Serein-28y/STM32_Smart_Car/文本记录/README.md

本项目的完整说明文档已经移动到仓库根目录，请查看：

[STM32 智能小车 README](../README.md)
