Serein-28y/STM32_Smart_Car/相关代码及PCB设计/V2.0.1/(UP主陈加油)STM32F1智能小车扩展板原理图.png

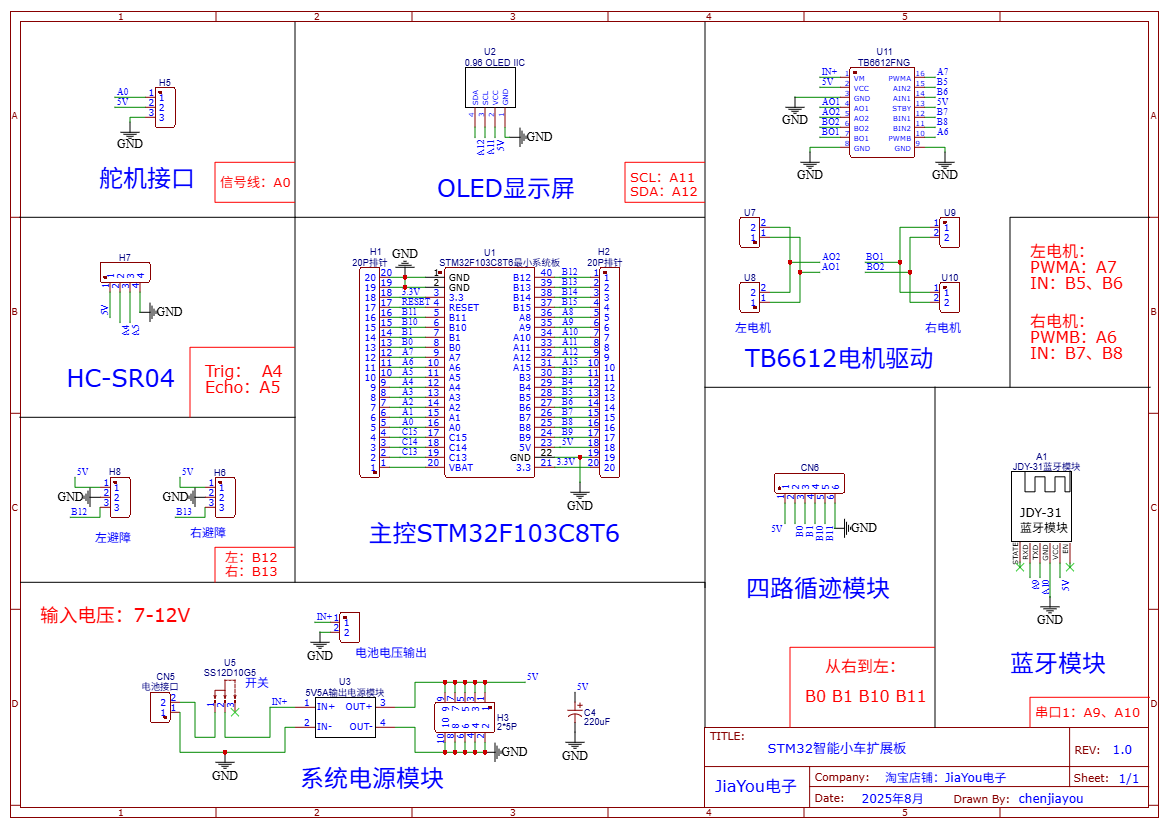
相关代码及PCB设计/V2.0.1/(UP主陈加油)STM32F1智能小车扩展板原理图.png
