Serein-28y/STM32_Smart_Car/相关代码及PCB设计/V2.0.1/SCH_STM32智能小车扩展板原理图_1-P1_2026-08-20.png

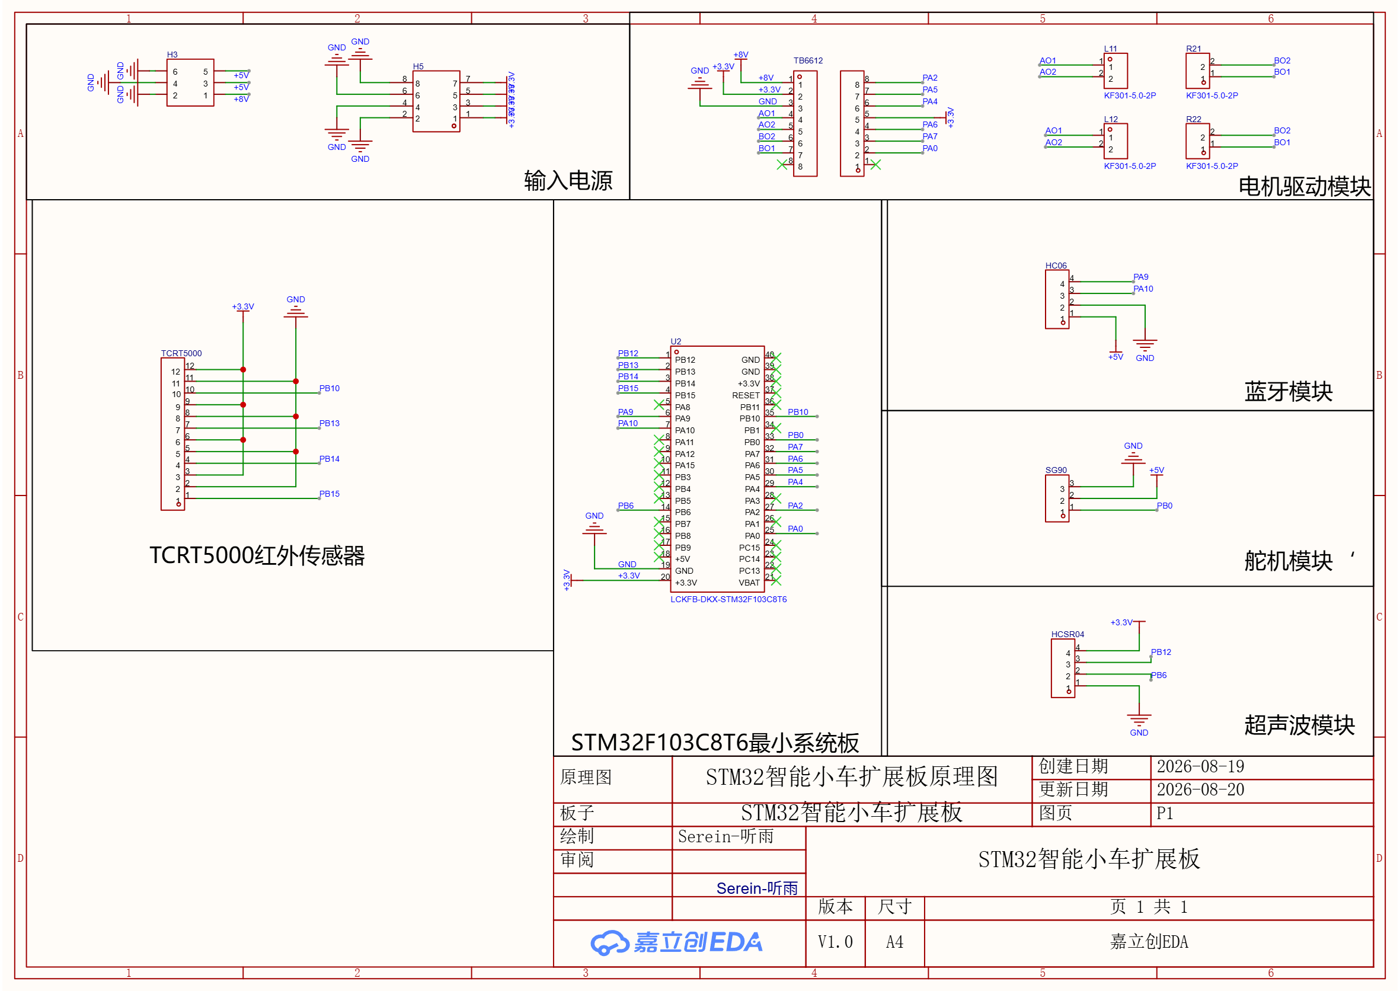
相关代码及PCB设计/V2.0.1/SCH_STM32智能小车扩展板原理图_1-P1_2026-08-20.png
