Serein-28y/STM32_Smart_Car/相关知识/GPIO输入输出模式.png

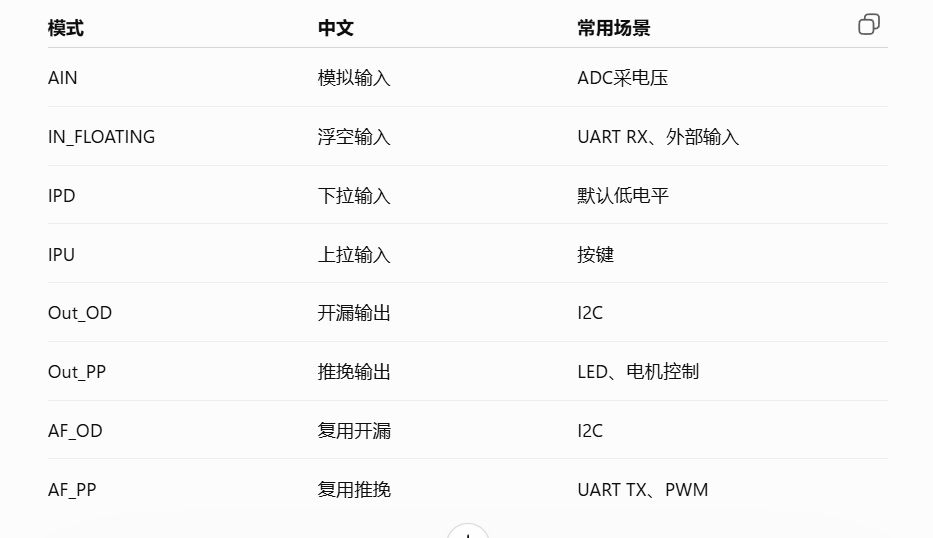
相关知识/GPIO输入输出模式.png
