Serein-28y/STM32_Smart_Car/相关知识/PWM参数计算.jpg

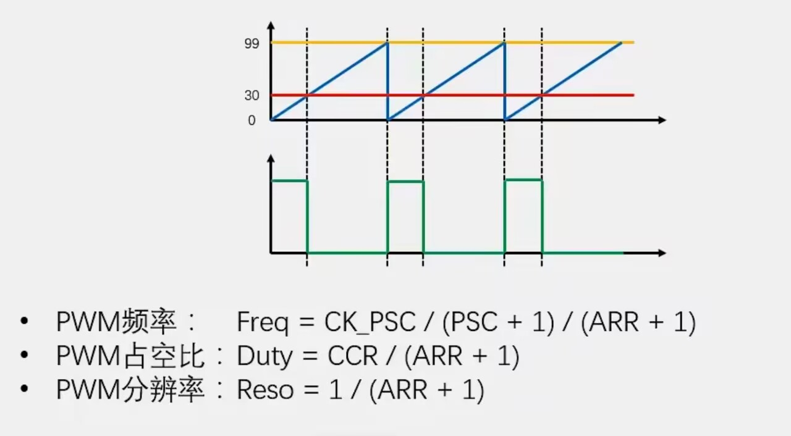
相关知识/PWM参数计算.jpg
