Serein-28y/STM32_Smart_Car/相关知识/系统架构.png

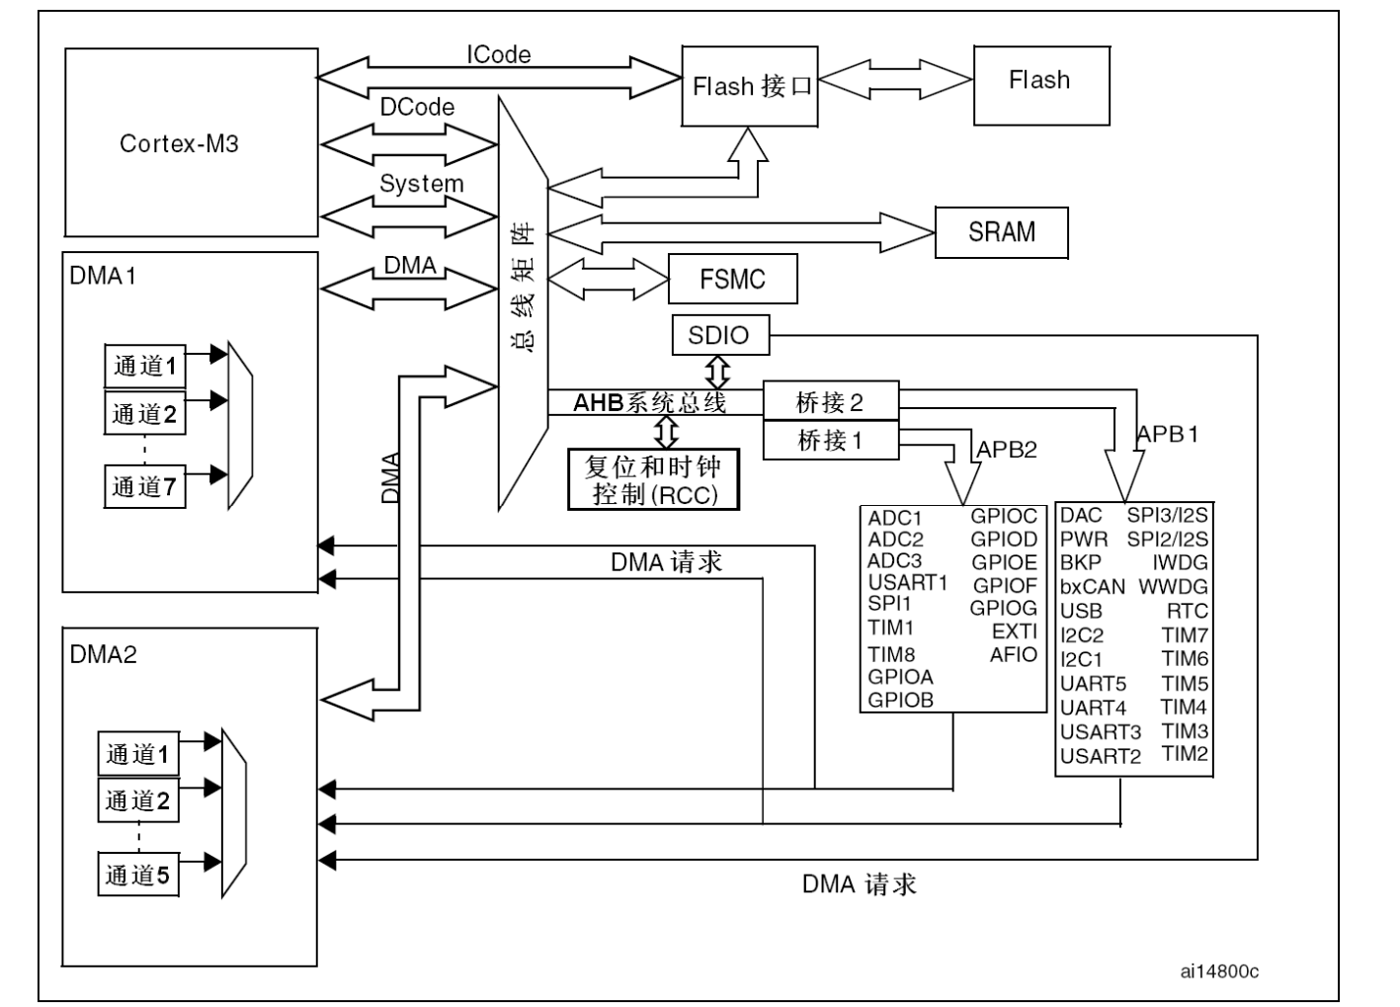
相关知识/系统架构.png
