Serein-28y/STM32_Smart_Car/相关代码及PCB设计/V2.0.1/BOM_STM32智能小车扩展板_STM32智能小车扩展板原理图_2026-08-20.xlsx

No. | Quantity | Comment | Designator | Footprint | Value | Manufacturer Part | Manufacturer | Supplier Part | Supplier
1 | 1 | HDR-M_2.54_2x3 | H3 | HDR-TH_6P-P2.54-V-R2-C3-S2.54_A2541WV-2X3P |  |  |  | C402781
2 | 2 | HDR-F_2.54_1x8P | H4,TB6612 | HDR-TH_8P-P2.54-V-F-1 |  |  |  | C27438
3 | 1 | HDR-M_2.54_2x4 | H5 | HDR-TH_8P-P2.54-V-M-R2-C4-S2.54 |  |  |  | C124386
4 | 1 | HDR-F_2.54_1x4P | HC06 | HDR-TH_4P-P2.54-V-F |  |  |  | C2718488
5 | 1 | HDR-M_2.54_1x4P | HCSR04 | HDR-TH_4P-P2.54-V-M |  |  |  | C492403
6 | 4 | KF301-5.0-2P | L11,L12,R21,R22 | CONN-TH_P5.00_KF301-5.0-2P |  | KF301-5.0-2P | KEFA(科发) | C474881 | LCSC
7 | 1 | HDR-M_2.54_1x3P | SG90 | HDR-TH_3P-P2.54-V-M |  |  |  | C2937625
8 | 1 | HDR-M_2.54_1x12P | TCRT5000 | HDR-TH_12P-P2.54-V-M |  |  |  | C2840012
9 | 1 | LCKFB-DKX-STM32F103C8T6 | U2 | CONN-TH_L53.3-W22.9_STM32F103C8T6-CARD |  | LCKFB-DKX-STM32F103C8T6 | 立创开发板 | C22396880 | LCSC
