Serein-28y/STM32_Smart_Car/(list of files, cad)

Other CAD files:
相关模块资料/模块资料/TCRT5000循迹模块/传感器51测试程序/STARTUP.OBJ
相关模块资料/模块资料/TCRT5000循迹模块/传感器51测试程序/1.OBJ
