Serein-28y/STM32_Smart_Car/文本记录/Problem.txt

1.焊接电机时没有考虑后面接线，线太细导致接线不稳
2.7_16解决PWM驱动四个TT电机，采用一个PWM1来输出波形，用通道1和通道3控制左右轮转速
3.7_17解决了供电问题，第一次测试用的四节南孚电池6V(测试电压为6.5V左右)，分两路，一路接TB6612的VM和GND端，一路通过AMS1117稳压3.3V接到STM32的3.3V和GND端
后续将采用锂电池18650供电7.4V（测试电压8.V左右）
4.

5.

6.7.30版的自动避障代码，
预测应为直行时检测到障碍物停车，然后后退，再左转一些距离然后停车
实际:检测到障碍物停车，然后一直在后退左转循环，检测出右边两个电机不转
8.6 将四节南孚电池换成12V18650，然后通过DC端口接四路电源模块，分别到3.3V提供STM32 TB6612逻辑电源，5V提供蓝牙和舵机模块
8V提供TB6612的VM
最后右侧电机还是不转，用万用表检测TB6612除了BO1和BO2两侧无电压，其他一切正常
将TB6612从面包板拆下来直接用杜邦线接各个IO口恢复基本正常，有时候需要调整接线
初步判断是面包板和TB6612 接触不良导致

8.6
开始自动避障进阶（加入舵机扫描）
8.7测试误差 速度50时，刹车有11cm的误差
舵机方向反了，避障的方向就会反！

后续硬件设计注意事项：
1. 目前电机连接线过细，连接不够牢固；后续更换质量更好、线径更合适且接口更可靠的连接线。
2. 面包板使用时间越长，越容易出现松动或接触不良，从而增加偶发故障。后续设计PCB控制板，减少面包板和临时接线的使用，提高整车连接的稳定性和可靠性。

后续 PCB 改进（V2.0.2）
1. 板子未加电源检测 LED，无法直观判断是否上电；需在电源轨与 GND 之间增加带限流电阻的电源指示 LED。
2. HC-06 蓝牙模块与 STM32 最小系统板距离过近，布局拥挤且可能相互干扰；需调整蓝牙接口位置，保持安全间距。
3. 板子上有两个电机接口的引脚序/极性接反，导致对应电机反转；需交换引脚序或修正丝印极性。
4. 电机线等走线在结构上可能需要绕线，存在交叉与遮挡；需优化接口位置、走线走向、接口防松与安装孔布局。
