Serein-28y/STM32_Smart_Car/相关代码及PCB设计/V2.0.1/SCH_STM32智能小车扩展板原理图_2026-08-20.pdf

输入电源 | 电机驱动模块

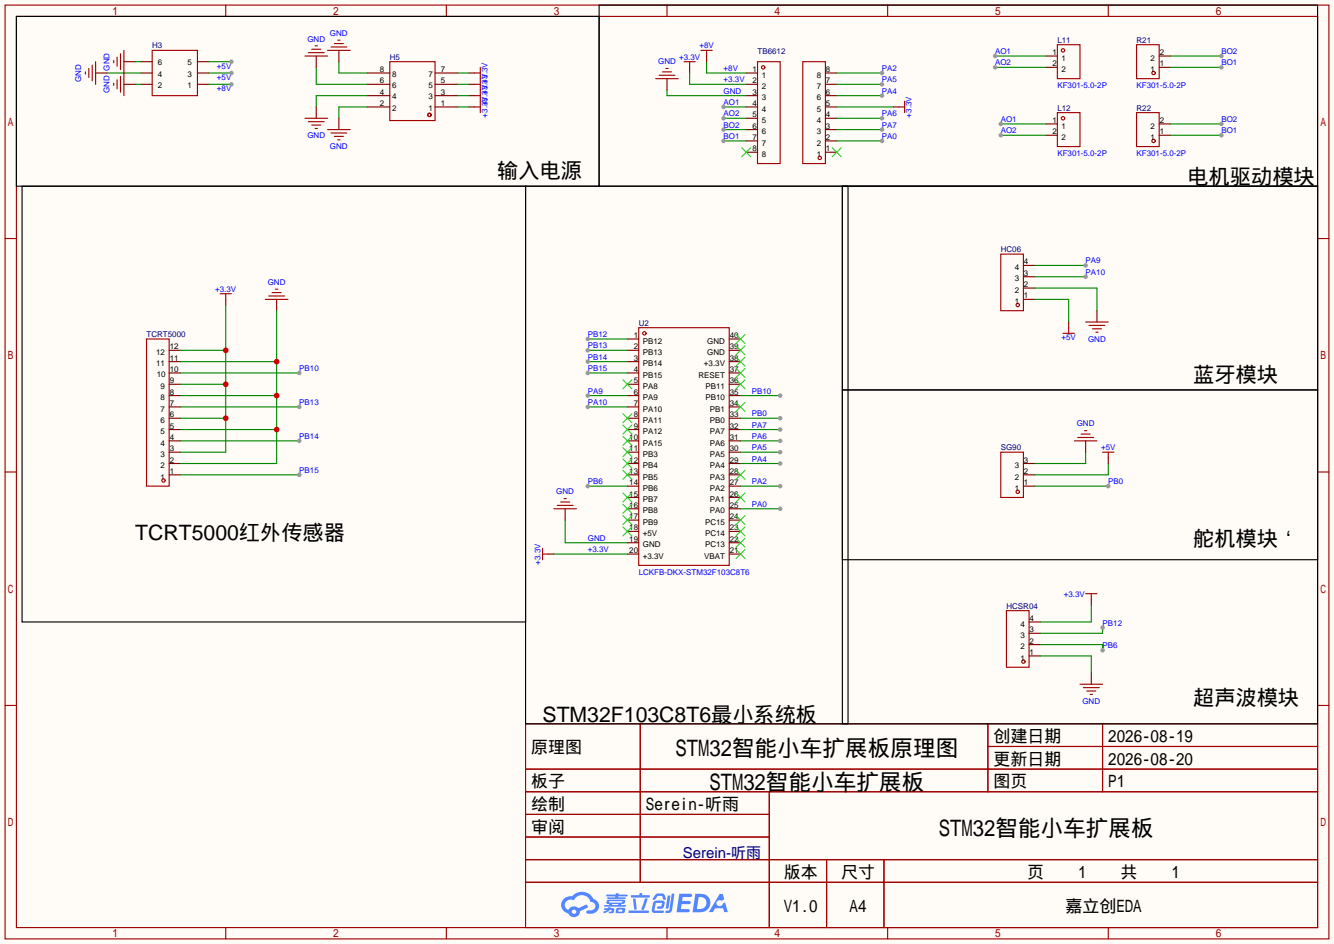
[picture p19: page 1]

原理图 | STM32智能小车扩展板原理图 | 创建日期 | 2026-08-19
板子 | STM32智能小车扩展板 | 图页 | P1
绘制 | Serein-听雨 | STM32智能小车扩展板
审阅

更新日期 | 2026-08-20

Serein-听雨

V1.0 | A4 | 嘉立创EDA
