Serein-28y/STM32_Smart_Car/相关模块资料/模块资料/TB6612FNG/TB6612电机驱动模块 (1).pdf

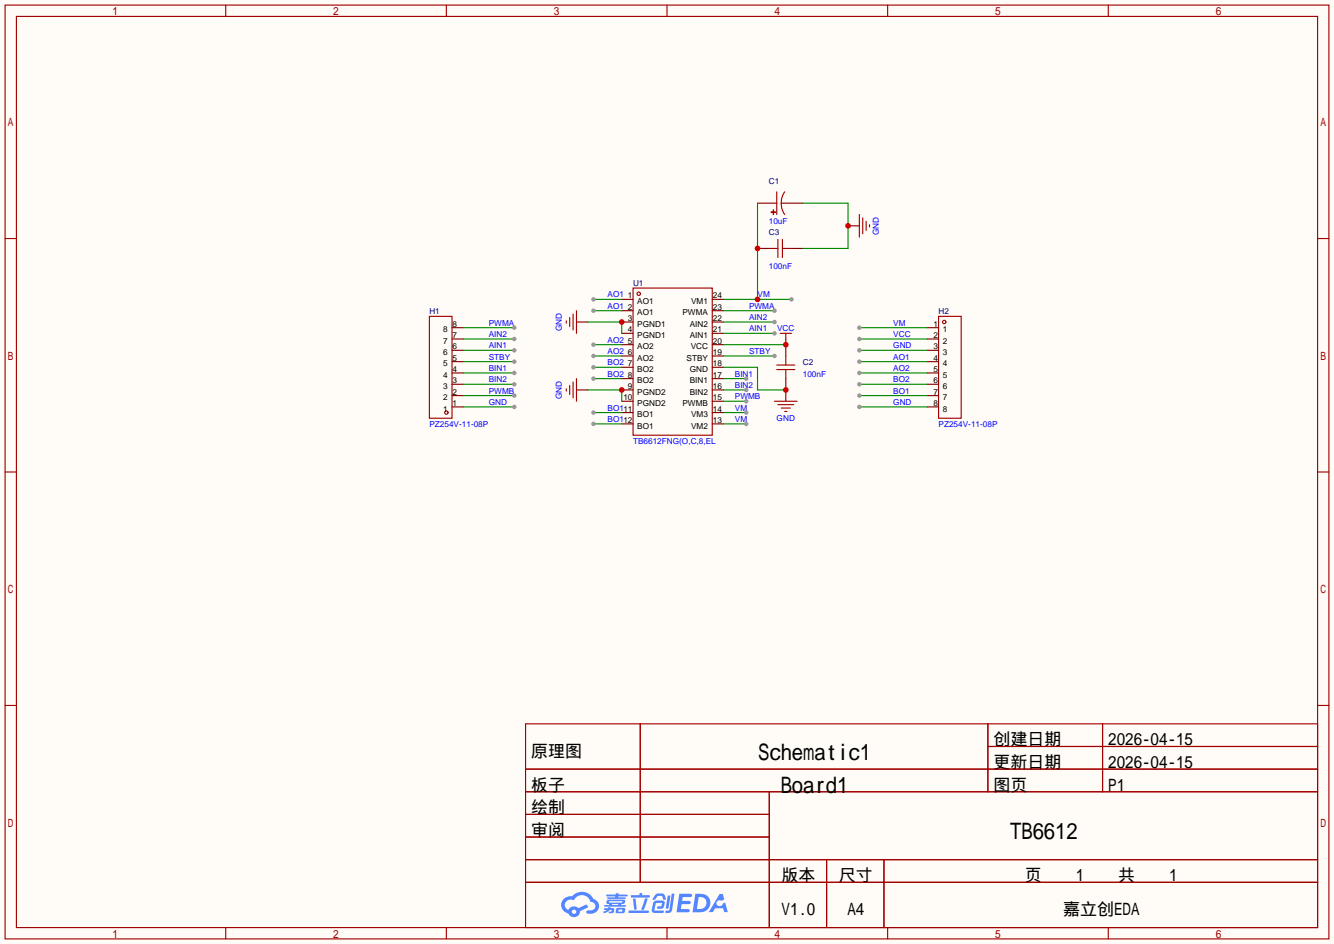
[picture p20: page 1]

原理图 | Schematic1 | 创建日期 | 2026-04-15

更新日期 | 2026-04-15

板子 | Board1 | 图页 | P1
绘制 | | TB6612
审阅

V1.0 | A4 | 嘉立创EDA
