Serein-28y/STM32_Smart_Car/相关模块资料/模块资料/LM2596多路电源模块3.3 5 12V ADJ可调输出/LM2596多路电源模块资料/LM2596-电路图.pdf

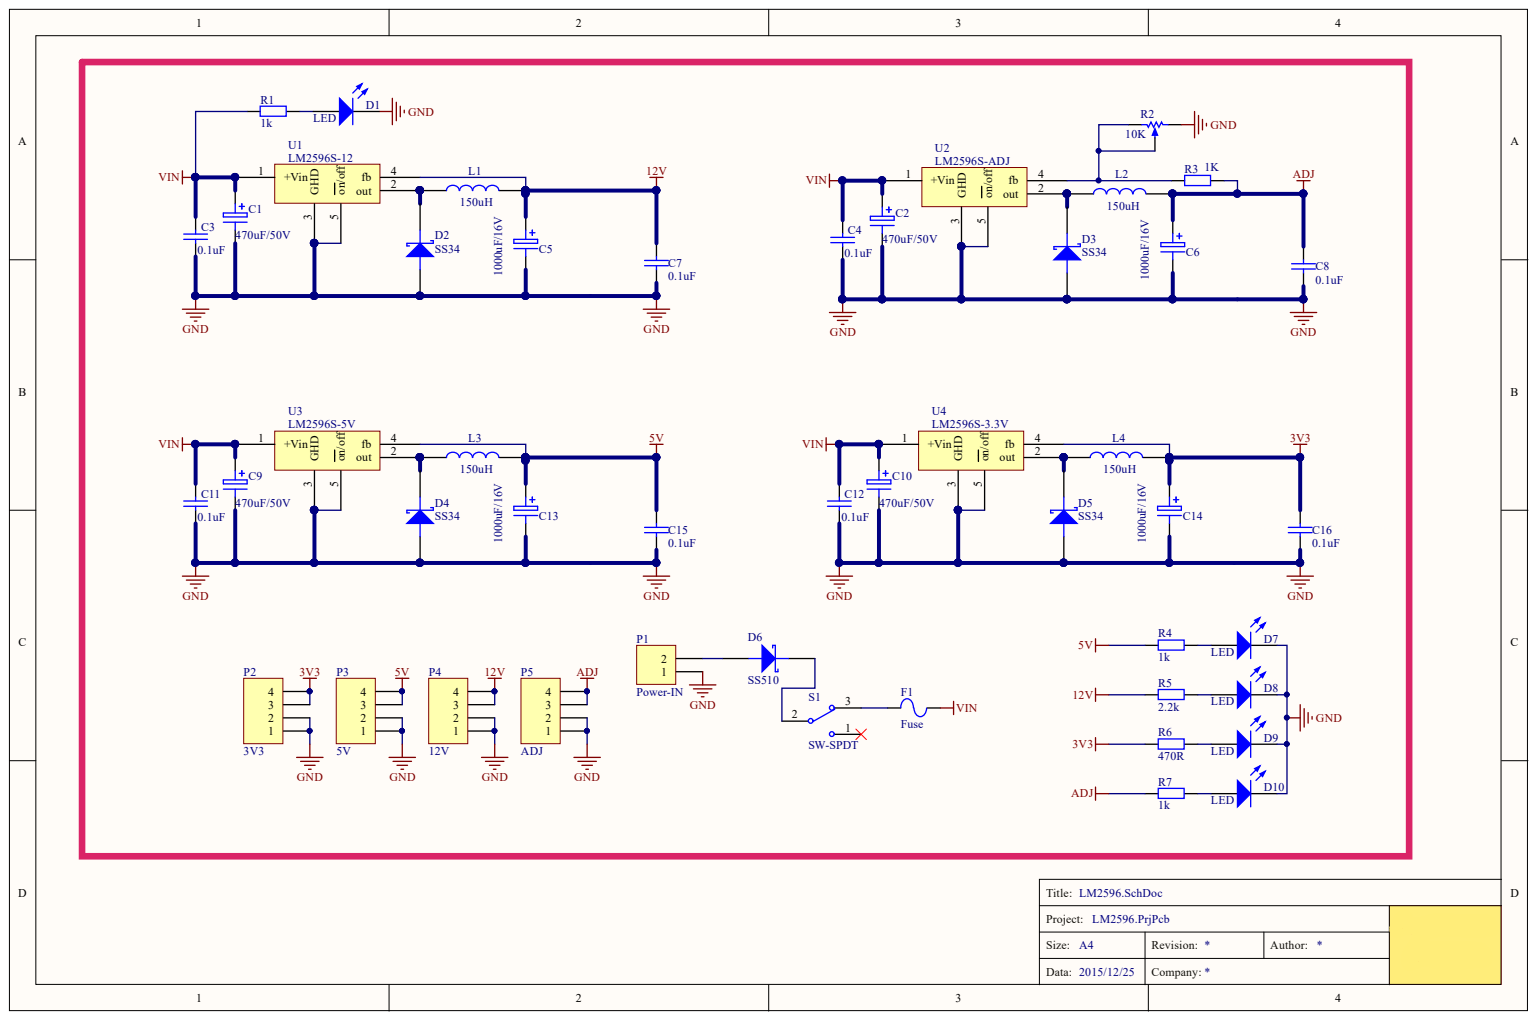
[picture p21: page 1]

Project: LM2596.PrjPcb | 康威科技 工作室

Size: A4 | Revision: * | Author: *

Data: 2015/12/25 | Company: *

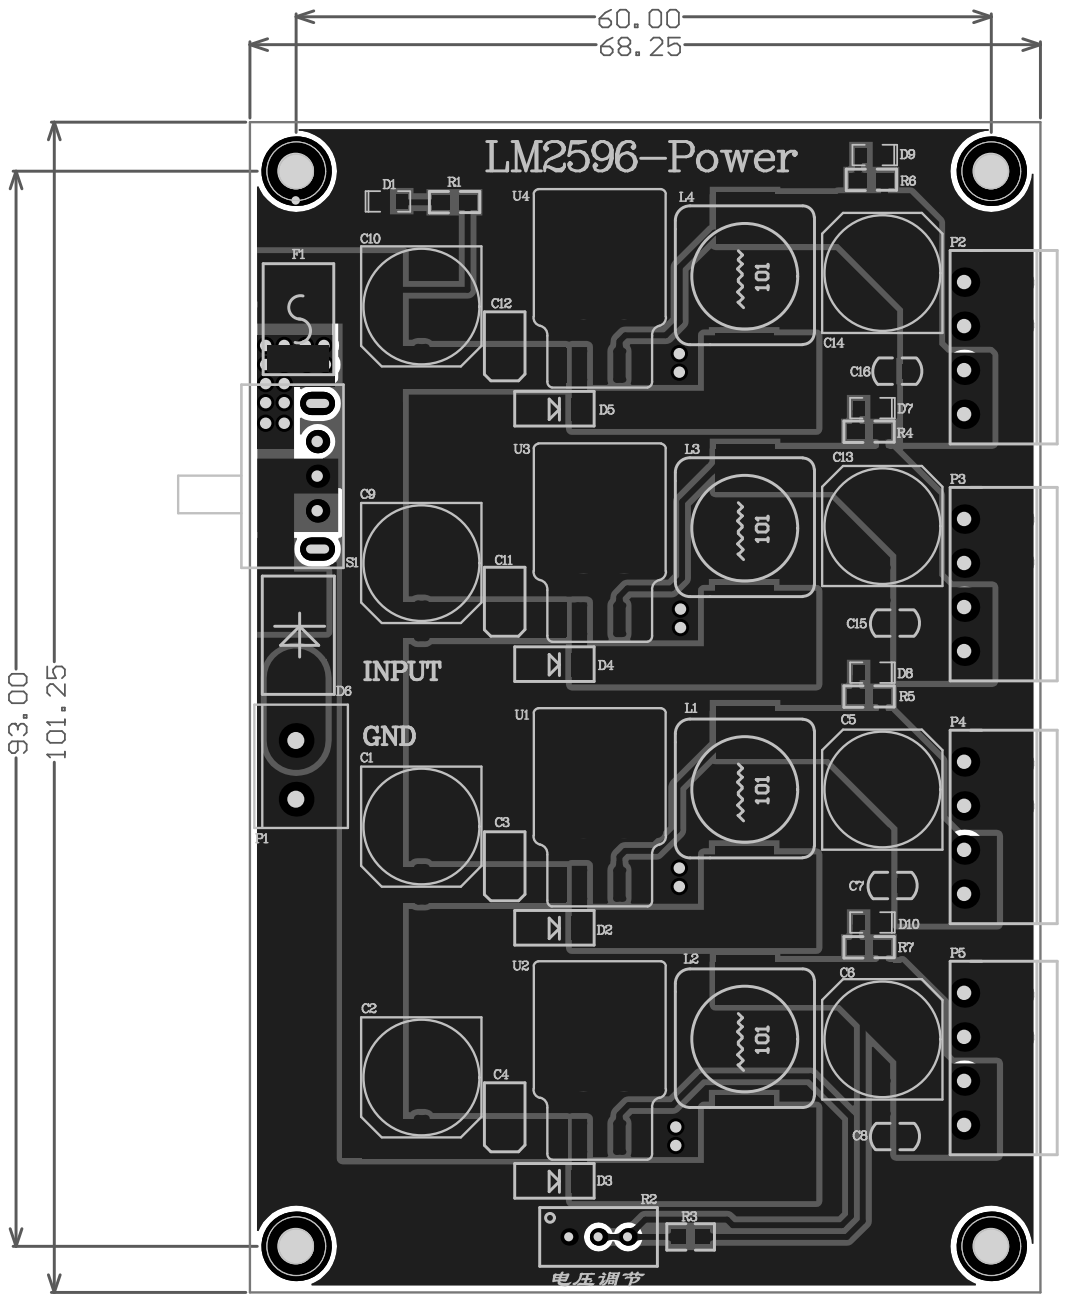
[picture p22: page 2]
