Serein-28y/STM32_Smart_Car/(commit log)

2026-07-15 第一次记录（测试）
2026-07-16 完成四个电机驱动
2026-07-17 问题解决更新（1）
2026-07-24 加入四轮驱动以及蓝牙（蓝牙还未模块化版本）
2026-07-24 蓝牙模块化（Serail）
2026-07-28 z增加舵机模块（测试舵机版本）
2026-07-29 增加超声波测距模块,需要将OLED删除（未删OLED代码版）
2026-07-30 超声波测距模块（调试端口已改为手机蓝牙调试器）
2026-07-30 试写版（未测试）
2026-08-06 避障测试版
2026-08-07 测试刹车距离
2026-08-09 最新版（加注释）
2026-08-10 循迹测试
2026-08-11 循迹V1.0
2026-08-13 功能整合
2026-08-14 8.14更新文档
2026-08-14 8.14增加演示视频
2026-08-14 8.14上传实物图
2026-08-14 8.14演示视频上传
2026-08-14 8.14增加模块资料及相关知识
    [1.OBJ, STARTUP.OBJ]
2026-08-20 8.20更像PCB设计
2026-08-20 8.20增加原理图及PCB
    [BOM_STM32智能小车扩展板_STM32智能小车扩展板原理图_2026-08-20.xlsx]
2026-08-20 8.20更新原理图及PCB
2026-09-03 8.20 增加PCB实物图并记录V2.0.2板子改进清单
    - 新增 V2.0.1 扩展板实物图与整车实物图，并在 README 中引用
    - 更新 README 进度：PCB 控制板标记为已完成（V2.0.1 打样焊接）
    - 在 README 后续改进计划与 Problem.txt 中记录 V2.0.2 改进清单
    - 新增 .gitignore 并取消跟踪 Keil/EIDE 编译产物，保持仓库干净
